floatAsNeeded/LineaMeteoStazione-Personalised-Weather-Station/Price.png

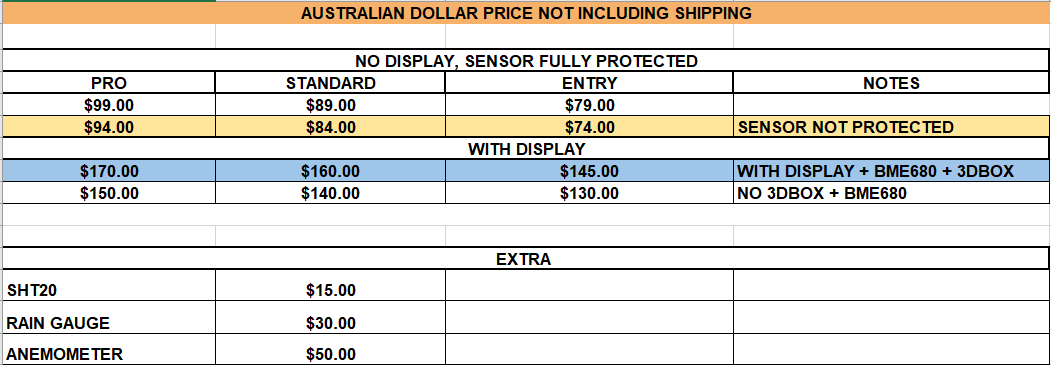
Price.png
