floatAsNeeded/LineaMeteoStazione-Personalised-Weather-Station/(threads)

Thread 1 (2025-03-16):

byte readTiny(int address) ?

L0cutus, 2025-03-16:
Non è inutile lo switch in questa funzione?
non sarebbe meglio una semplice funzione (vedi in fondo) ?
Scusa se ho detto cazzate, son parecchio nuovo alla programmazione arduino ;-)

```
byte readTiny(int address) {
  byte rawRead;
  switch (ReadByte) {
    case 0:
      Wire.requestFrom(address, 1);                  // The TinyWire library only allows for one byte to be requested at a time
      while (Wire.available() == 0)  Serial.print("W");
      rawRead = Wire.read();
      return rawRead;
      ReadByte = 1;
      break;
    case 1:
      Wire.requestFrom(address, 1);                  // The TinyWire library only allows for one byte to be requested at a time
      while (Wire.available() == 0)  Serial.print("W");
      rawRead = Wire.read();
      return rawRead;
      ReadByte = 2;
      break;
    case 2:
      Wire.requestFrom(address, 1);                  // The TinyWire library only allows for one byte to be requested at a time
      while (Wire.available() == 0)  Serial.print("W");
      rawRead = Wire.read();
      return rawRead;
      ReadByte = 3;
      break;
    case 3:
      Wire.requestFrom(address, 1);                  // The TinyWire library only allows for one byte to be requested at a time
      while (Wire.available() == 0)  Serial.print("W");
      rawRead = Wire.read();
      return rawRead;
      ReadByte = 4;
      break;
    case 4:
      Wire.requestFrom(address, 1);                  // The TinyWire library only allows for one byte to be requested at a time
      while (Wire.available() == 0)  Serial.print("W");
      rawRead = Wire.read();
      return rawRead;
      ReadByte = 5;
      break;
    case 5:
      Wire.requestFrom(address, 1);                  // The TinyWire library only allows for one byte to be requested at a time
      while (Wire.available() == 0)  Serial.print("W");
      rawRead = Wire.read();
      return rawRead;
      ReadByte = 0;
      break;
  }
}
```

```
byte readTiny(int address) {
  byte rawRead;
  Wire.requestFrom(address, 1);                  // The TinyWire library only allows for one byte to be requested at a time
  while (Wire.available() == 0)  Serial.print("W");
  rawRead = Wire.read();
  return rawRead;
}

```

floatAsNeeded, 2025-03-17:
Onestamente hai ragione. :) Quel codice lo avevo fatto molto tempo fa. Vedendolo ora ci vedrei un sacco di miglioramenti. Anche se adesso sto creando una stazione meteo migliore e con l'utilizzo di LoRa node to node pure ;)
